thinandcurious/eurorack-as3340-vco/README.md

# eurorack-as3340-vco

Design based on Skull & Circuits VCO-1: https://www.skullandcircuits.com/the-oscillator-one
