thinandcurious/eurorack-as3340-vco/pcb/AS3340 vco rev1 schematics.pdf

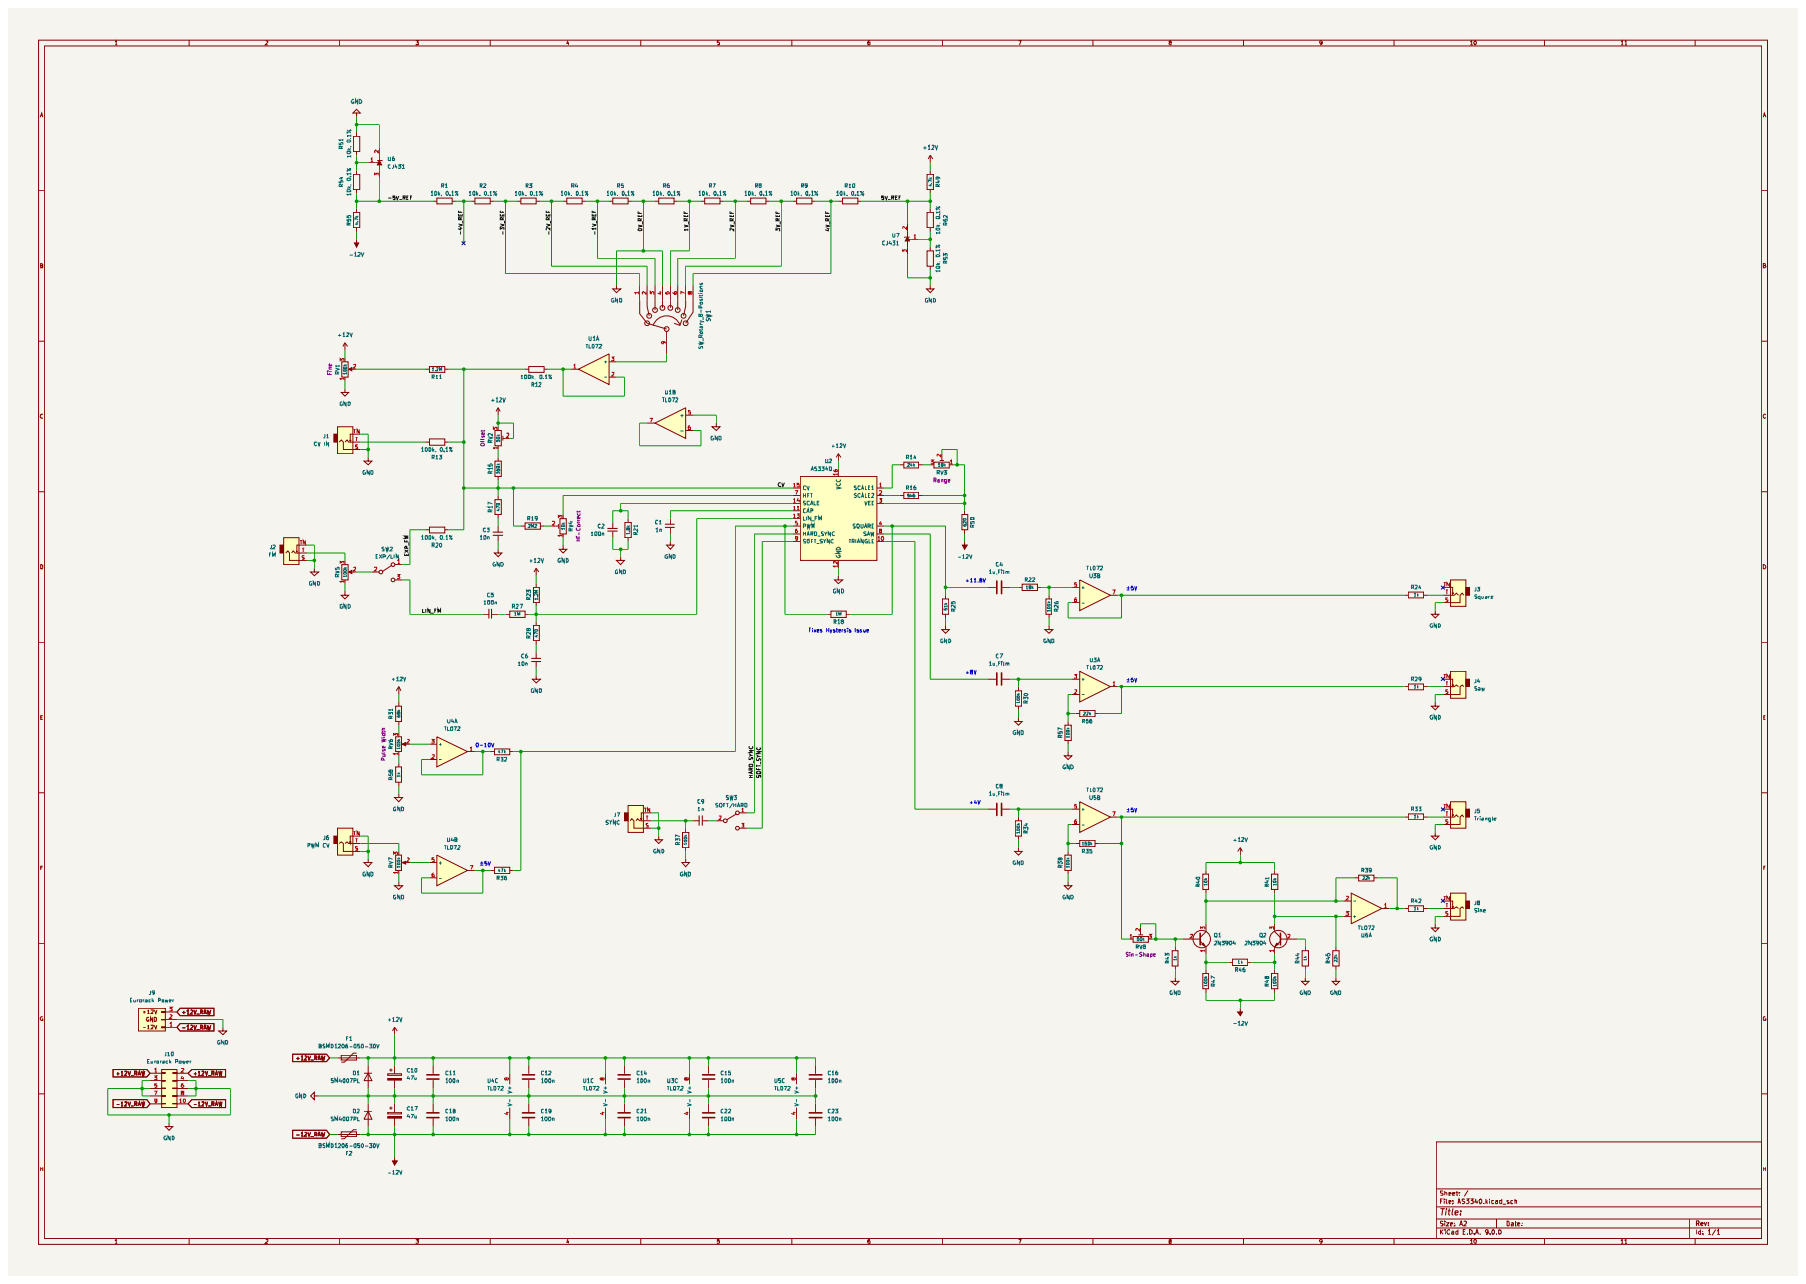
[picture p1: page 1]
