thinandcurious/eurorack-as3340-vco/pcb/AS3340.kicad_pcb

## KiCad design pcb/AS3340.kicad_pcb (2025-03-17)

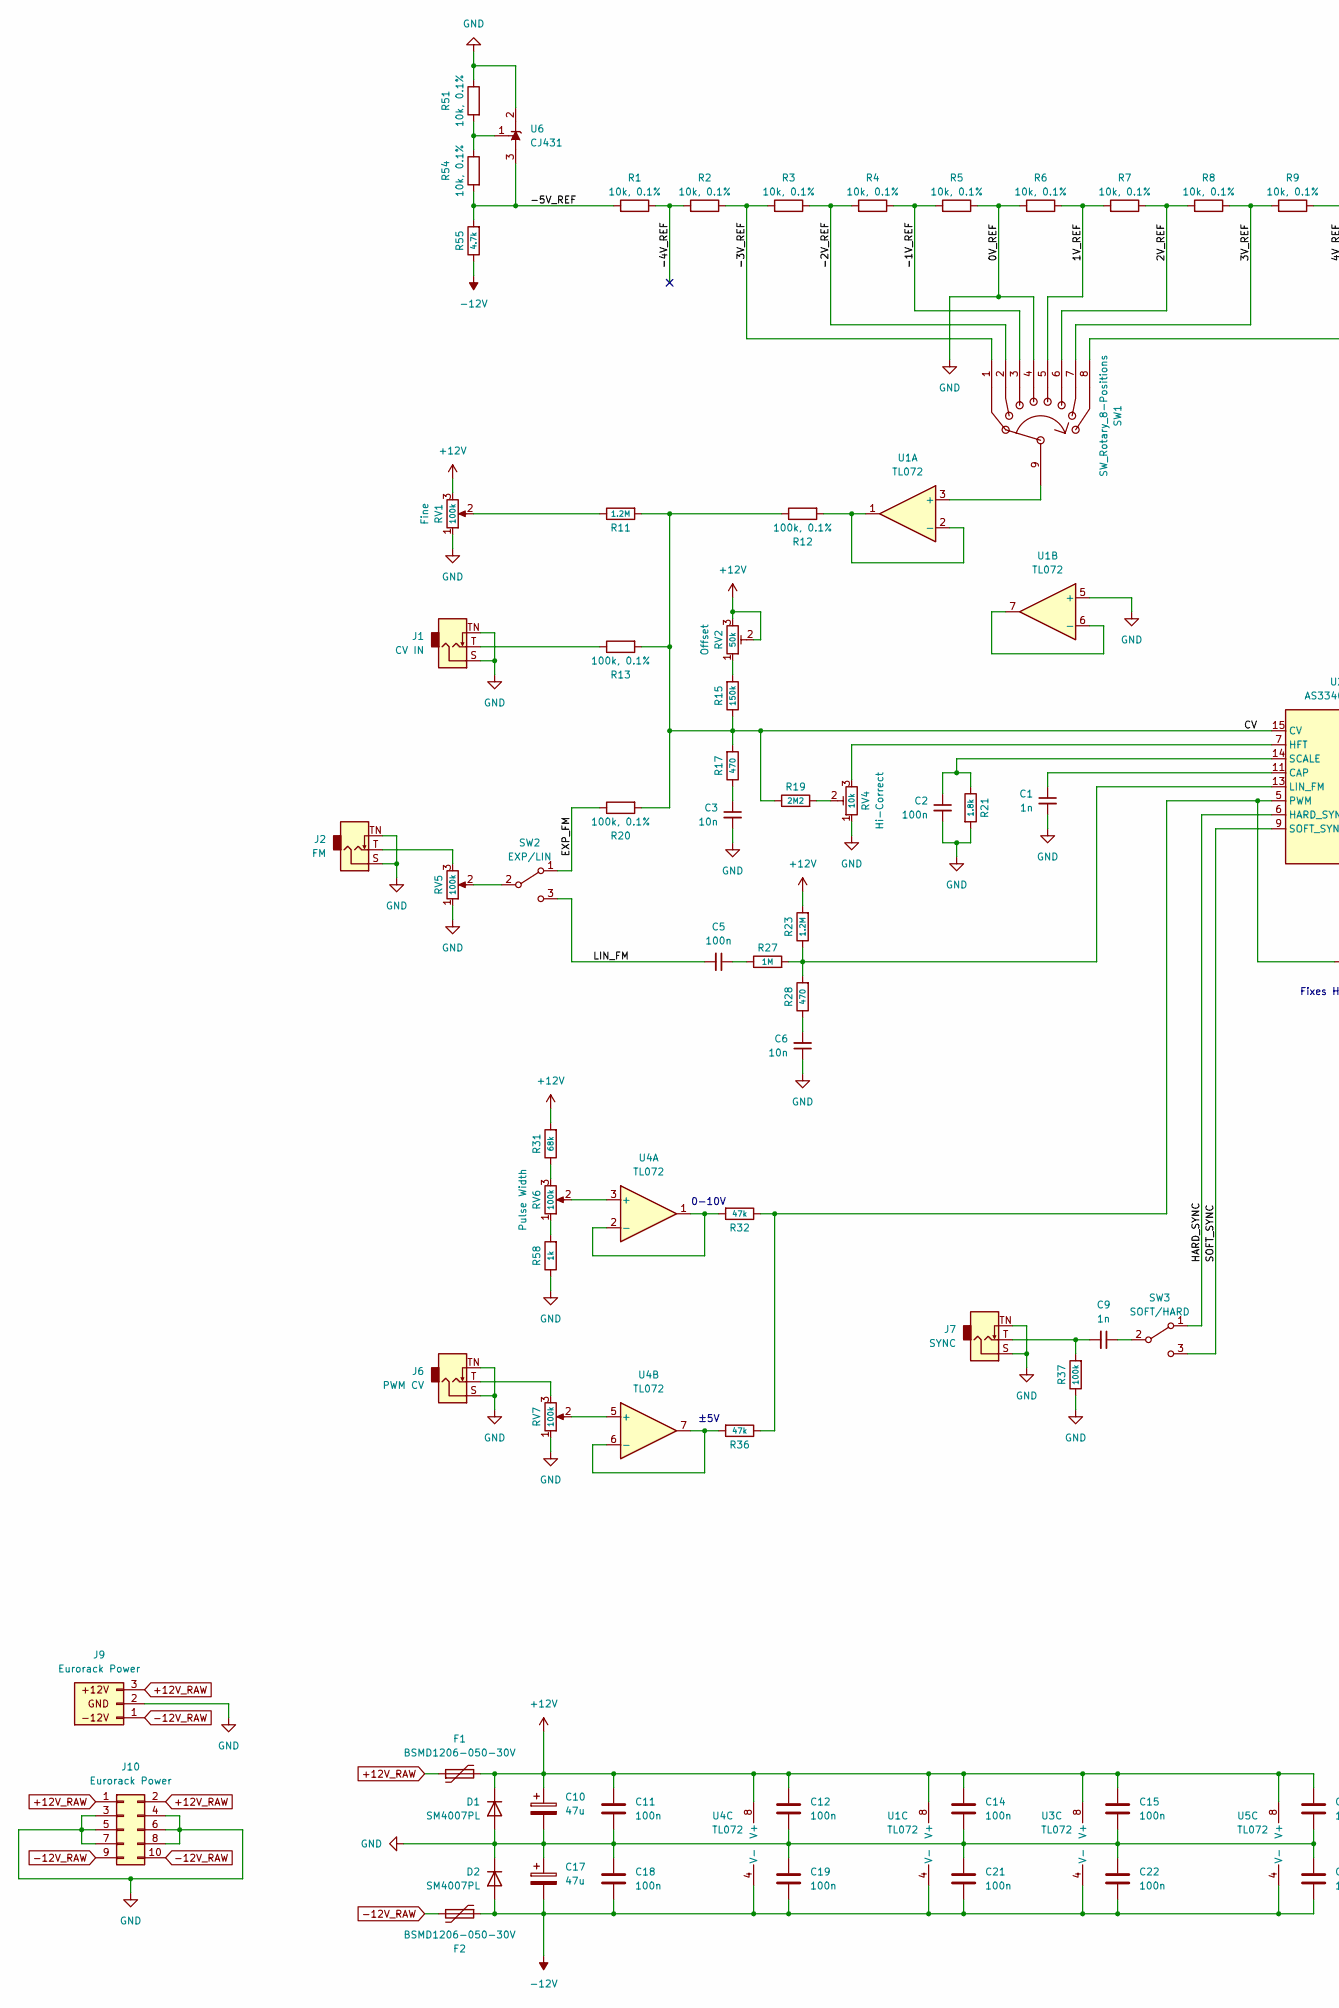
[picture p2: schematic AS3340.kicad_sch, part in row 1, column 1]

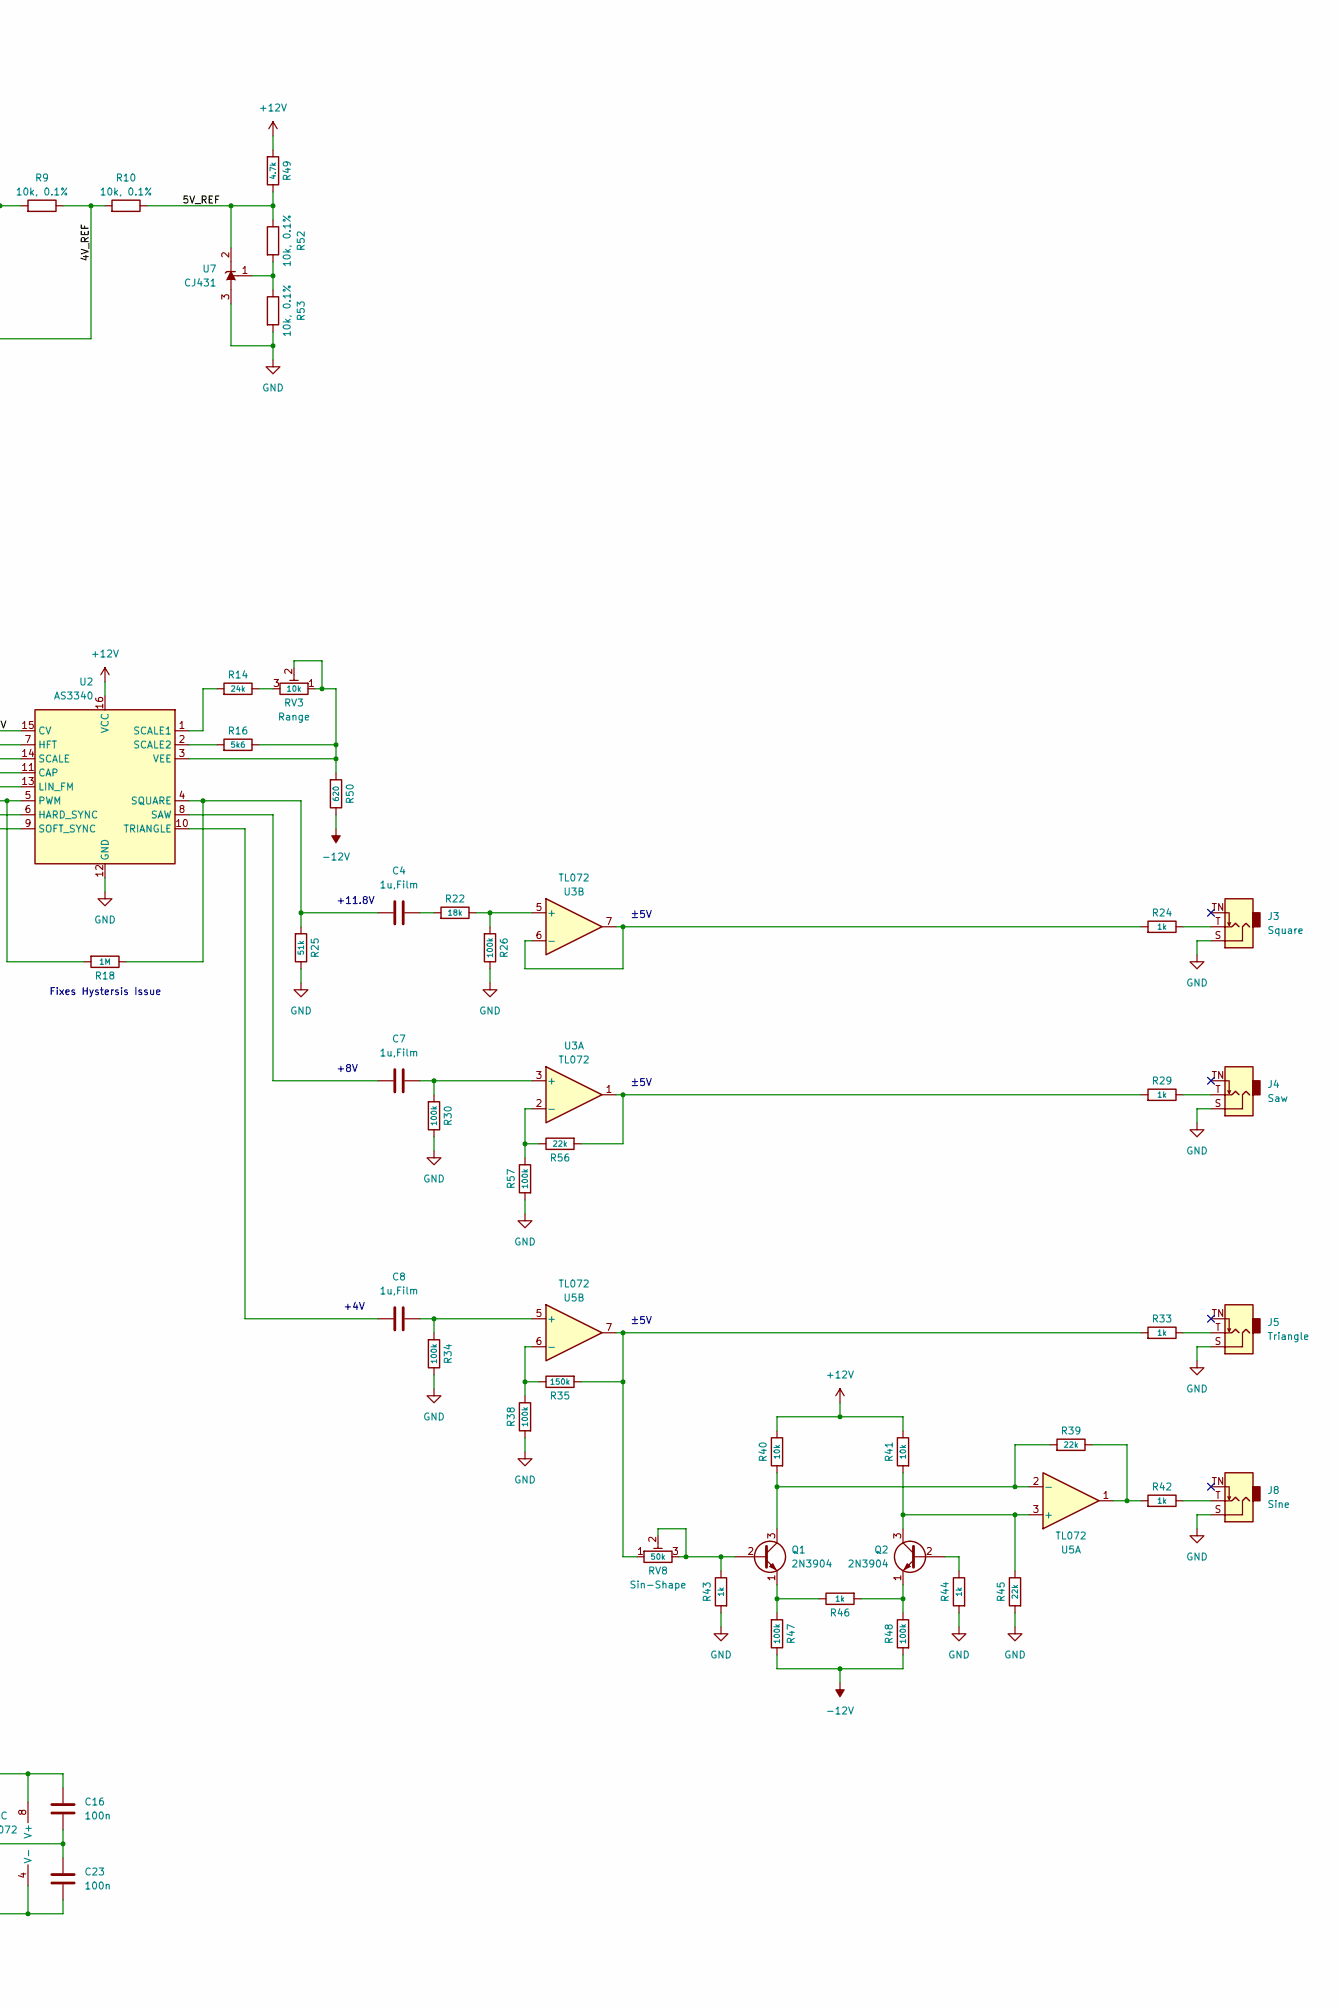
[picture p3: schematic AS3340.kicad_sch, part in row 1, column 2]

Parts:
C1, C9: 1n; C_0603_1608Metric; LCSC C1588
C2, C5, C11, C12, C14, C15, C16, C18, C19, C21, C22, C23: 100n; C_0603_1608Metric; LCSC C14663
C3, C6: 10n; C_0603_1608Metric; LCSC C57112
C4, C7, C8: 1u,Film; C_Rect_L7.2mm_W5.5mm_P5.00mm_FKS2_FKP2_MKS2_MKP2
C10, C17: 47u; CP_Radial_D6.3mm_P2.50mm
D1, D2: SM4007PL; D_SOD-123F; LCSC C64898
F1, F2: BSMD1206-050-30V; Fuse_1206_3216Metric; LCSC C883126
J1: CV IN; Jack_3.5mm_PJ398SM_Vertical
J2: FM; Jack_3.5mm_PJ398SM_Vertical
J3: Square; Jack_3.5mm_PJ398SM_Vertical
J4: Saw; Jack_3.5mm_PJ398SM_Vertical
J5: Triangle; Jack_3.5mm_PJ398SM_Vertical
J6: PWM CV; Jack_3.5mm_PJ398SM_Vertical
J7: SYNC; Jack_3.5mm_PJ398SM_Vertical
J8: Sine; Jack_3.5mm_PJ398SM_Vertical
J9: Eurorack Power; JST_XH_B3B-XH-A_1x03_P2.50mm_Vertical
J10: Eurorack Power; PinHeader_2x05_P2.54mm_Vertical
Q1, Q2: 2N3904; TO-92_Inline_Wide
R1, R2, R3, R4, R5, R6, R7, R8, R9, R10, R51, R52, R53, R54: 10k, 0.1%; R_0603_1608Metric; LCSC C309083
R11: 1.2M; R_1206_3216Metric_Pad1.30x1.75mm_HandSolder; LCSC C22107
R12, R13, R20: 100k, 0.1%; R_0603_1608Metric; LCSC C335088
R14: 24k; R_0603_1608Metric; LCSC C23352
R15, R35: 150k; R_0603_1608Metric; LCSC C22807
R16: 5k6; R_0603_1608Metric; LCSC C23189
R17, R28: 470; R_0603_1608Metric; LCSC C23179
R18, R27: 1M; R_0603_1608Metric; LCSC C22935
R19: 2M2; R_0603_1608Metric; LCSC C22938
R21: 1.8k; R_0603_1608Metric; LCSC C4177
R22: 18k; R_0603_1608Metric; LCSC C25810
R23: 1.2M; R_1206_3216Metric; LCSC C22107
R24, R29, R33, R42, R43, R44, R46, R58: 1k; R_0603_1608Metric; LCSC C21190
R25: 51k; R_0603_1608Metric; LCSC C23196
R26, R30, R34, R37, R38, R47, R48, R57: 100k; R_0603_1608Metric; LCSC C25803
R31: 68k; R_0603_1608Metric; LCSC C23231
R32, R36: 47k; R_0603_1608Metric; LCSC C25819
R39, R45, R56: 22k; R_0603_1608Metric; LCSC C31850
R40, R41: 10k; R_0603_1608Metric; LCSC C25804
R49, R55: 4.7k; R_0603_1608Metric; LCSC C23162
R50: 620; R_0603_1608Metric; LCSC C23220
RV1, RV5, RV6, RV7: 100k; Potentiometer_Alpha_RD901F
RV2, RV8: 50k; Potentiometer_Bourns_3296Y_Vertical
RV3, RV4: 10k; Potentiometer_Bourns_3296Y_Vertical
SW1: SW_Rotary_8-Positions; Switch_1P8T_Rotary
SW2: EXP/LIN; Switch_SPDT_Micro-Toggle
SW3: SOFT/HARD; Switch_SPDT_Micro-Toggle
U1, U3, U4, U5: TL072; SOIC-8_3.9x4.9mm_P1.27mm; LCSC C6961
U2: AS3340; DIP-16_W7.62mm
U6, U7: CJ431; SOT-23; LCSC C3113

Connections:
+12V: C10.1, C11.1, C12.1, C14.1, C15.1, C16.1, D1.1 (K), F1.2, R23.2, R31.2, R40.1, R41.1, R49.2, RV1.3, RV2.2, RV2.3, U1.8 (V+), U2.16 (VCC), U3.8 (V+), U4.8 (V+), U5.8 (V+)
+12V_RAW: F1.1, J9.3, J10.1, J10.2
-12V: C17.2, C18.2, C19.2, C21.2, C22.2, C23.2, D2.2 (A), F2.1, R47.1, R48.2, R50.1, R55.1, U1.4 (V-), U3.4 (V-), U4.4 (V-), U5.4 (V-)
-12V_RAW: F2.2, J9.1, J10.9, J10.10
/1V_REF: R6.1, R7.2, SW1.5
/2V_REF: R7.1, R8.2, SW1.6
/3V_REF: R8.1, R9.2, SW1.7
/4V_REF: R9.1, R10.2, SW1.8
/5V_REF: R10.1, R49.1, R52.1, U7.2 (K)
/-1V_REF: R4.1, R5.2, SW1.3
/-2V_REF: R3.1, R4.2, SW1.2
/-3V_REF: R2.1, R3.2, SW1.1
/-4V_REF: R1.1, R2.2
/-5V_REF: R1.2, R54.2, R55.2, U6.3 (A)
/CV: R11.2, R12.1, R13.2, R15.1, R17.2, R19.1, R20.2, U2.15 (CV)
/EXP_FM: R20.1, SW2.1 (A)
/HARD_SYNC: SW3.1 (A), U2.6 (HARD_SYNC)
/LIN_FM: C5.2, SW2.3 (C)
/SOFT_SYNC: SW3.3 (C), U2.9 (SOFT_SYNC)
GND: C1.2, C2.2, C3.2, C6.1, C10.2, C11.2, C12.2, C14.2, C15.2, C16.2, C17.1, C18.1, C19.1, C21.1, C22.1, C23.1, D1.2 (A), D2.1 (K), J1.S, J1.TN, J2.S, J2.TN, J3.S, J4.S, J5.S, J6.S, J6.TN, J7.S, J7.TN, J8.S, J9.2, J10.3, J10.4, J10.5, J10.6, J10.7, J10.8, R5.1, R6.2, R21.2, R25.1, R26.1, R30.1, R34.1, R37.1, R38.2, R43.2, R44.2, R45.2, R51.1, R53.2, R57.2, R58.1, RV1.1, RV4.1, RV5.1, RV7.1, SW1.4, U1.5 (+), U2.12 (GND), U6.2 (K), U7.3 (A)
unnamed: C1.1, U2.11 (CAP)
unnamed: C2.1, R21.1, U2.14 (SCALE)
unnamed: C3.1, R17.1
unnamed: C4.1, R18.1, R25.2, U2.4 (SQUARE)
unnamed: C4.2, R22.2
unnamed: C5.1, R27.1
unnamed: C6.2, R28.1
unnamed: C7.1, U2.8 (SAW)
unnamed: C7.2, R30.2, U3.3 (+)
unnamed: C8.1, U2.10 (TRIANGLE)
unnamed: C8.2, R34.2, U5.5 (+)
unnamed: C9.1, SW3.2 (B)
unnamed: C9.2, J7.T, R37.2
unnamed: J1.T, R13.1
unnamed: J2.T, RV5.3
unnamed: J3.T, R24.1
unnamed: J4.T, R29.1
unnamed: J5.T, R33.1
unnamed: J6.T, RV7.3
unnamed: J8.T, R42.1
unnamed: Q1.1 (E), R46.1, R47.2
unnamed: Q1.2 (B), R43.1, RV8.2, RV8.3
unnamed: Q1.3 (C), R39.2, R40.2, U5.2 (-)
unnamed: Q2.1 (E), R46.2, R48.1
unnamed: Q2.2 (B), R44.1
unnamed: Q2.3 (C), R41.2, R45.1, U5.3 (+)
unnamed: R11.1, RV1.2
unnamed: R12.2, U1.1, U1.2 (-)
unnamed: R14.1, RV3.3
unnamed: R14.2, U2.1 (SCALE1)
unnamed: R15.2, RV2.1
unnamed: R16.1, R50.2, RV3.1, RV3.2, U2.3 (VEE)
unnamed: R16.2, U2.2 (SCALE2)
unnamed: R18.2, R32.1, R36.1, U2.5 (PWM)
unnamed: R19.2, RV4.2
unnamed: R22.1, R26.2, U3.5 (+)
unnamed: R23.1, R27.2, R28.2, U2.13 (LIN_FM)
unnamed: R24.2, U3.6 (-), U3.7
unnamed: R29.2, R56.2, U3.1
unnamed: R31.1, RV6.3
unnamed: R32.2, U4.1, U4.2 (-)
unnamed: R33.2, R35.2, RV8.1, U5.7
unnamed: R35.1, R38.1, U5.6 (-)
unnamed: R36.2, U4.6 (-), U4.7
unnamed: R39.1, R42.2, U5.1
unnamed: R51.2, R54.1, U6.1 (REF)
unnamed: R52.2, R53.1, U7.1 (REF)
unnamed: R56.1, R57.1, U3.2 (-)
unnamed: R58.2, RV6.1
unnamed: RV4.3, U2.7 (HFT)
unnamed: RV5.2, SW2.2 (B)
unnamed: RV6.2, U4.3 (+)
unnamed: RV7.2, U4.5 (+)
unnamed: SW1.9, U1.3 (+)
unnamed: U1.6 (-), U1.7

Notes on the sheet:
±5V
Fixes Hystersis Issue
0-10V
+8V
+11.8V
+4V

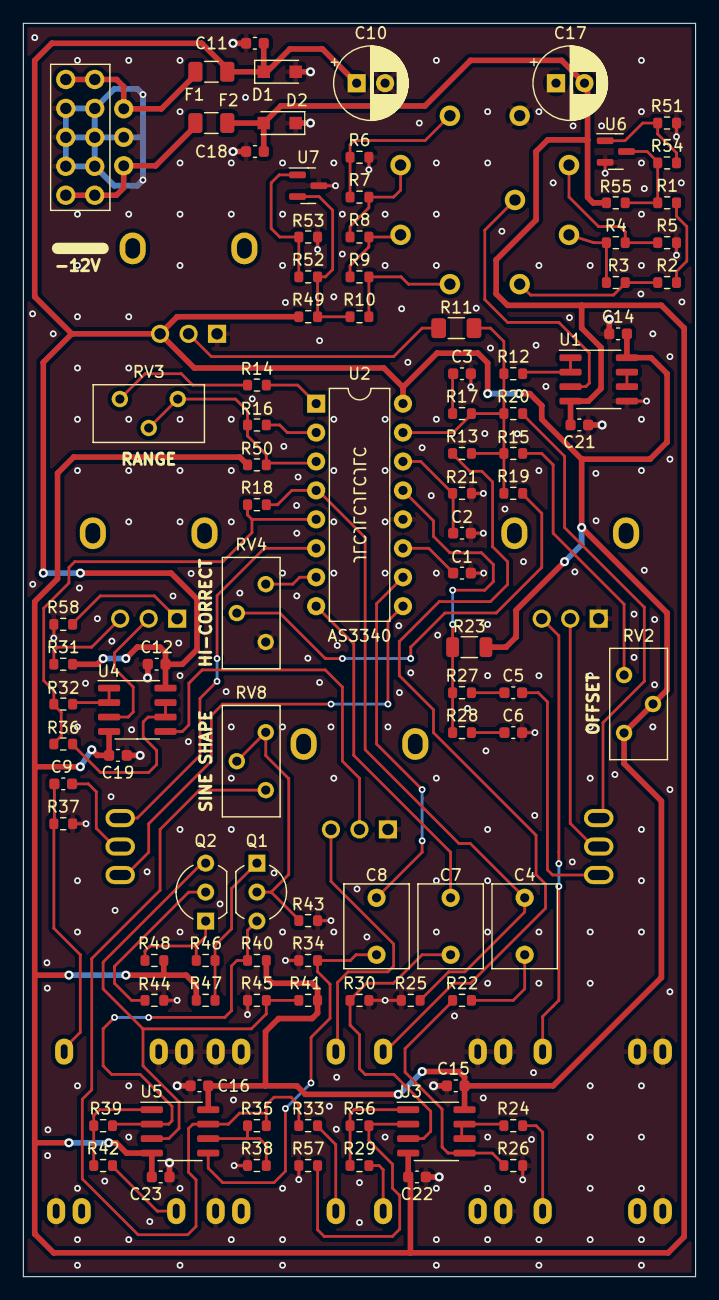
[picture p4: board AS3340.kicad_pcb from above]

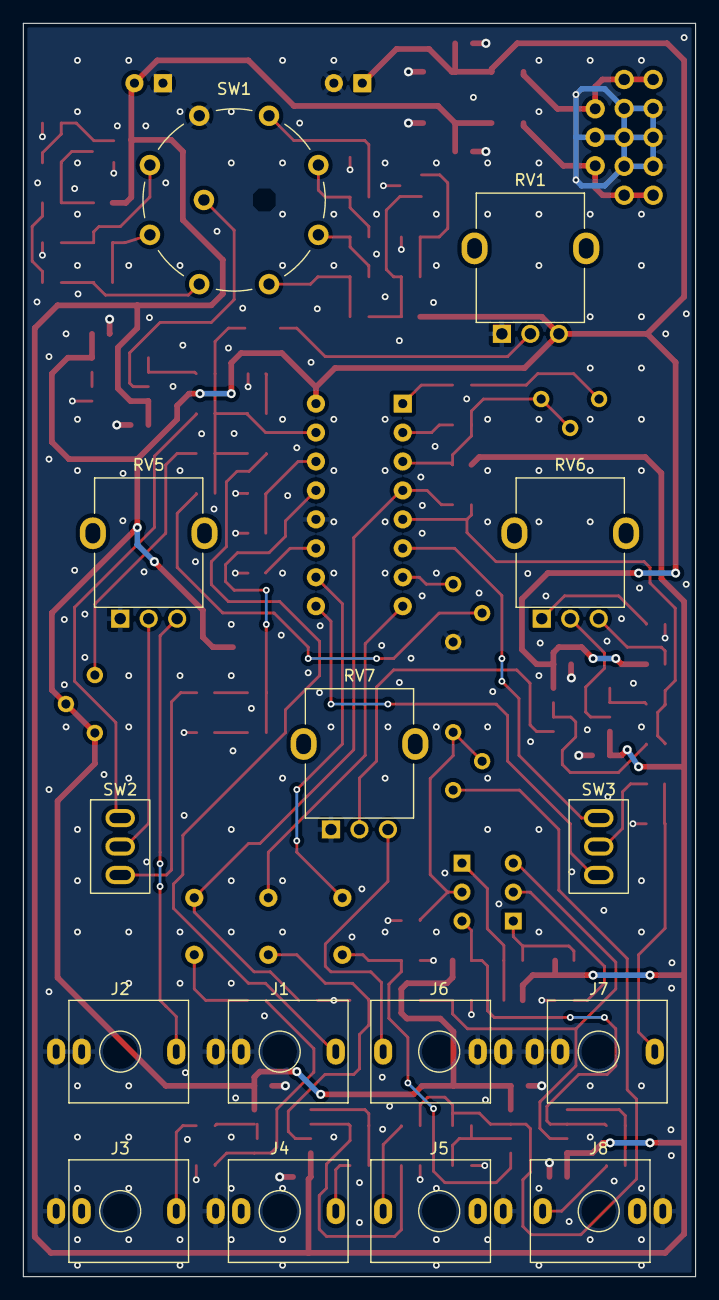
[picture p5: board AS3340.kicad_pcb from below]

Board: 2 copper layers, 59.0 x 110.0 mm, 113 parts (15 on the bottom side), 75 nets.
